lantti/orcu/receiverPCB/LRK.kicad_pcb

## KiCad design receiverPCB/LRK.kicad_pcb (2017-09-18)

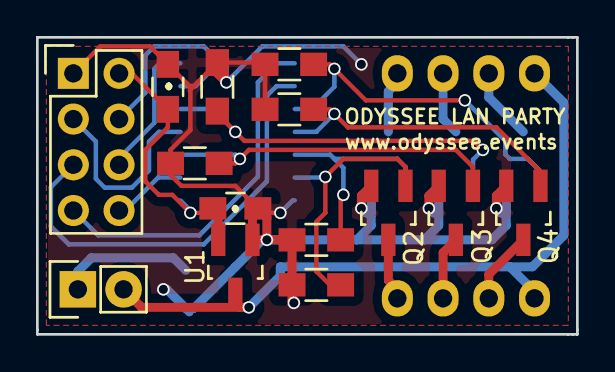
[picture p1: board LRK.kicad_pcb from above]

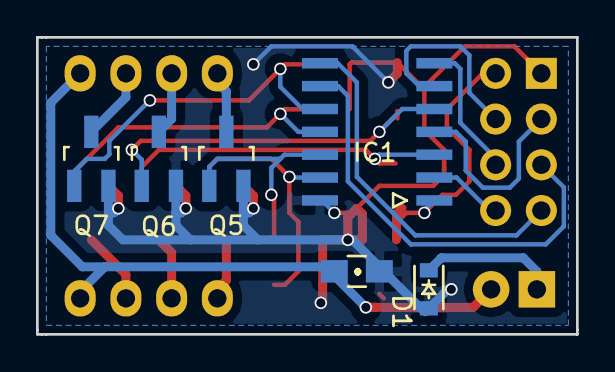
[picture p2: board LRK.kicad_pcb from below]

Board: 2 copper layers, 30.0 x 16.5 mm, 22 parts (6 on the bottom side), 22 nets.

Parts:
C2, C3, C4: C; C_0805_HandSoldering
D1: CUS15S30; SOD-323_hand
IC1: ATTINY24A-SS; SOIC-14_hand
P1: PWR; Pin_Header_Straight_1x02
P2: RFMODULE; Pin_Header_Straight_2x04
P3, P4: LEDS; Pin_Header_Straight_1x04
Q2, Q3, Q4, Q5, Q6, Q7: IRLML2402; SOT-23_Handsoldering
R3, R4, R5, R6, R7, R8: R; R_0805_HandSoldering
U1: AP2210; SOT-23_Handsoldering

Connections:
+3V3: C2.1, C4.2, IC1.1, P2.2, U1.2
+12V: C3.1, P1.2, P3.4, P4.4, U1.3
/0V: D1.1, P1.1
/CE|RESET: IC1.4, P2.3
/CSN: IC1.6, P2.4
/IRQ|SCI: IC1.2, P2.8
/MISO|SII: IC1.8, P2.7
/MOSI|SDI: IC1.7, P2.6
/SCK|SDO: IC1.9, P2.5
/ledB1: IC1.11, Q4.1, R5.1
/ledB1_out: P3.3, Q4.3
/ledB2: IC1.10, Q7.1, R8.1
/ledB2_out: P4.3, Q7.3
/ledG1: IC1.3, Q3.1, R4.1
/ledG1_out: P3.2, Q3.3
/ledG2: IC1.5, Q6.1, R7.1
/ledG2_out: P4.2, Q6.3
/ledR1: IC1.13, Q2.1, R3.1
/ledR1_out: P3.1, Q2.3
/ledR2: IC1.12, Q5.1, R6.1
/ledR2_out: P4.1, Q5.3
GND: C2.2, C3.2, C4.1, D1.2, IC1.14, P2.1, Q2.2, Q3.2, Q4.2, Q5.2, Q6.2, Q7.2, R3.2, R4.2, R5.2, R6.2, R7.2, R8.2, U1.1
