lantti/orcu/transmitter/orcuadmin.py

import orcumaster
import orcuui
import sys
import intelhex


PAGECOUNT = 64
PAGESIZE = 64
MAXPAYLOAD = 28
MAXATTEMPTS = 15
manualText = ['Orcu Admin', '', 'Commands:', 'q[uit]', 's[elect] <row>', 
              'u[nselect] <row>', 'p[ing]',
              'a[ddress] <row> <column> <channel>',
              'l[oad] <filename>', 'f[lash]']

channel = int(sys.argv[1])
ih = intelhex.IntelHex()

def splitSegments(segList):
  pageLists = [[0] for _ in range(PAGECOUNT)] 
  for s in segList:
    sBeg = s[0]
    sEnd = s[1]
    while (sBeg < sEnd):
      page = sBeg // PAGESIZE
      pageEnd = (page + 1) * PAGESIZE
      plEnd = sBeg + MAXPAYLOAD
      newEnd = min(pageEnd, plEnd, sEnd)
      pageLists[page][0] += newEnd - sBeg
      pageLists[page].append((sBeg,newEnd))
      sBeg = newEnd
  return pageLists

print("Starting, please wait...")

with orcuui.OrcuUI(['q','quit']) as ui, orcumaster.orcumaster(channel) as orcu:
  def echoCb(ui, cmdline, selected):
    ui.writeResult('Echo: ' + cmdline + ' ' + str(selected))

  def loadCb(ui, cmdline, selected):
    global ih
    try:
      filename = cmdline.split()[1]
      ih = intelhex.IntelHex()
      ih.loadhex(filename)
      ui.writeResult('Loaded ' + filename)
    except (IndexError, FileNotFoundError, intelhex.IntelHexError):
      ui.writeResult('Please supply a valid Intel Hex file')

  def pingCb(ui, cmdline, selected):
    for u in selected:
      row = u[0]
      column = u[1]
      ui.writeResult('Pinging (' + str(row) + ',' + str(column) + ')')
      ui.unmarkUnit(row, column)
      ping = orcu.ocPing(row, column)
      if ping[0]:
        splitPing = ''.join(ping[1]).split('\x00')
        if len(splitPing) > 1:
          mark = splitPing[1] + '/' + splitPing[0]
        else:
          mark = 'unknown'
        ui.markUnit(row, column, mark)
        ui.writeResult('Pinging (' + str(row) + ',' + str(column) + ')...Ok!')
      else:
        ui.writeResult('Pinging (' + str(row) + ',' + str(column) + ')...Fail!')


  def rowSelectCb(ui, cmdline, selected):
    try:
      row = int(cmdline.split()[1])
      if cmdline[0] == 's':
        f = ui.selectUnit
      else:
        f = ui.unselectUnit
      for column in range(0,256):
        f(row,column)
      ui.writeResult('')
    except ValueError:
      ui.writeResult('Please supply a valid row number')

  def flashCb(ui, cmdline, selected):
    pages = splitSegments(ih.segments())
    for u in selected:
      row = u[0]
      column = u[1]
      fail = False
      wrote = False
      ui.unmarkUnit(row, column)
      ui.writeResult('Flashing (' + str(row) + ',' + str(column) + ')')
      for p in range(PAGECOUNT):
        if pages[p][0] == 0:
          continue
        if pages[p][0] != PAGESIZE:
          success = False
          attempt = 0
          while not success and attempt < MAXATTEMPTS:
            attempt += 1
            (success, errno) = orcu.ocLoadPage(row, column, p)
          if not success or errno != 0:
            fail = True
            break
        for s in pages[p][1:]:
          success = False
          attempt = 0
          while not success and attempt < MAXATTEMPTS:
            attempt += 1
            (success, errno) = orcu.ocWriteBuffer(row, column, s[0]-p*PAGESIZE, list(ih[s[0]:s[1]].tobinarray()))
          if not success or errno != 0:
            fail = True
            break
        if fail:
          break
        success = False
        attempt = 0
        while not success and attempt < MAXATTEMPTS:
          attempt += 1
          (success, _) = orcu.ocProgramPage(row, column, p)
        if not success or errno != 0:
          fail = True
          break
        wrote = True
      if fail:
        if wrote:
          ui.writeResult('Flashing (' + str(row) + ',' + str(column) + ')...Fail! (Bricked)')
          ui.markUnit(row, column, 'bricked')
        else:
          ui.writeResult('Flashing (' + str(row) + ',' + str(column) + ')...Fail!')
      else:
        orcu.ocForceReset(row, column)
        ui.writeResult('Flashing (' + str(row) + ',' + str(column) + ')...Ok!')

  def addressCb(ui, cmdline, selected):
    if len(selected) == 1:
      oldrow = selected[0][0]
      oldcolumn = selected[0][1]
      cmdwords = cmdline.split()
      try:
        newrow = int(cmdwords[1])
        newcolumn = int(cmdwords[2])
        newchannel = int(cmdwords[3])
        ui.unmarkUnit(oldrow, oldcolumn)
        ui.writeResult('Setting address (' + str(newrow) + ',' + str(newcolumn) + ')@' + str(newchannel) + ' for (' + str(oldrow) + ',' + str(oldcolumn) + ')@' + str(channel))
        (success, errno) = orcu.ocChangeChannelAndAddress(oldrow, oldcolumn, newrow, newcolumn, newchannel)
        if not success or errno != 0:
          ui.writeResult('Setting address (' + str(newrow) + ',' + str(newcolumn) + ')@' + str(newchannel) + ' for (' + str(oldrow) + ',' + str(oldcolumn) + ')@' + str(channel) + '...Fail!')
        else:
          ui.writeResult('Setting address (' + str(newrow) + ',' + str(newcolumn) + ')@' + str(newchannel) + ' for (' + str(oldrow) + ',' + str(oldcolumn) + ')@' + str(channel) + '...Ok!')
      except ValueError:
        ui.writeResult('Please supply valid row, column and channel numbers')
    else:
      ui.writeResult('Please select exactly one unit for address change')
      

  ui.registerCallback('echo', echoCb)
  ui.registerCallback('e', echoCb)
  ui.registerCallback('ping', pingCb)
  ui.registerCallback('p', pingCb)
  ui.registerCallback('select', rowSelectCb)
  ui.registerCallback('s', rowSelectCb)
  ui.registerCallback('unselect', rowSelectCb)
  ui.registerCallback('u', rowSelectCb)
  ui.registerCallback('load', loadCb)
  ui.registerCallback('l', loadCb)
  ui.registerCallback('flash', flashCb)
  ui.registerCallback('f', flashCb)
  ui.registerCallback('address', addressCb)
  ui.registerCallback('a', addressCb)
  ui.setManualText(manualText)
  ui.start()

print("Bye!")
