lantti/orcu/(commit log)

2017-09-18 transfer in receiver PCB design from the old LRK repo
    [LRK.kicad_pcb, LRK.sch, LRK15.kicad_pcb]
2017-09-19 add bootup reset for rf module registers
    [bootloader.asm]
2017-10-07 Fix bootloader failing to use vector table for some module calls, Fix off-by-one in flash page calculation,rename output pins
    [bootloader.asm]
2017-11-30 Add rgb and indexed colour input features + fix eeprom write size limitation bug
    [bootloader.asm, mod_lrk2.asm]
2018-01-29 Add nrf24l01p driver, orcumaster and partial master code for lrk module
2018-02-06 Add admin UI frame
2018-02-15 Separate ui and admin modules, add flashing functionality to admin, fix bugs
    [orcuadmin.py, orcumaster.py, orcuui.py]
2018-02-18 Add controls for the LRK module + fix bugs that popped up in process
    [mod_lrk_master.py, nrf24l01p.py, orcuadmin.py, orcuui.py]
2018-02-21 Add raw mode, change crc to two bytes, use cursor position in ui if nothing selected, fix bugs that appeared
    [bootloader.asm, mod_lrk_master.py, mod_test2.asm, nrf24l01p.py, orcumaster.py, orcuui.py]
2018-02-22 Add readme, fix bugs
    [mod_lrk_master.py, orcuadmin.py, orcumaster.py]
2018-02-23 Make flashing function try harder in case of transmission failures
    [orcuadmin.py]
2018-02-27 Mark units that are likely bricked after a failed flashing operation
    [orcuadmin.py]
